SunZillaBerlin/Score/README.md

# SunZilla Score
...is a hard- and software package
