SunZillaBerlin/Score/1 - DOCUMENTATION/5 - Score_PCB_Function_Groups.pdf

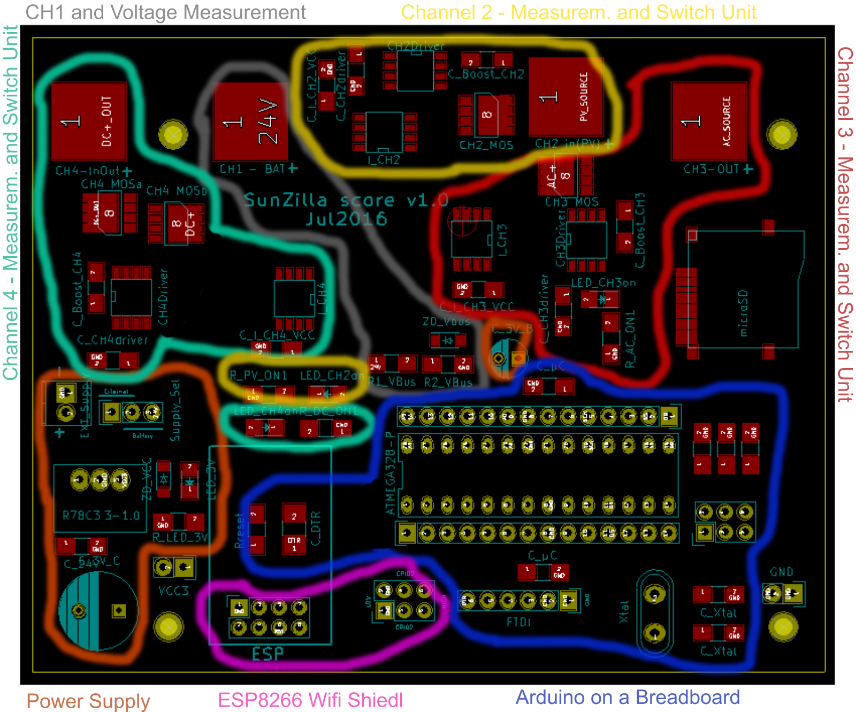
[picture p1: page 1]

PowerSupply | ESP8266WifiShiedl | ArduinoonaBreadboard

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
CH1andVoltageMeasurement Channel2-Measurem.andSwitchUnit
