SunZillaBerlin/Score/1 - DOCUMENTATION/3 - Score_PCB_Overview.pdf

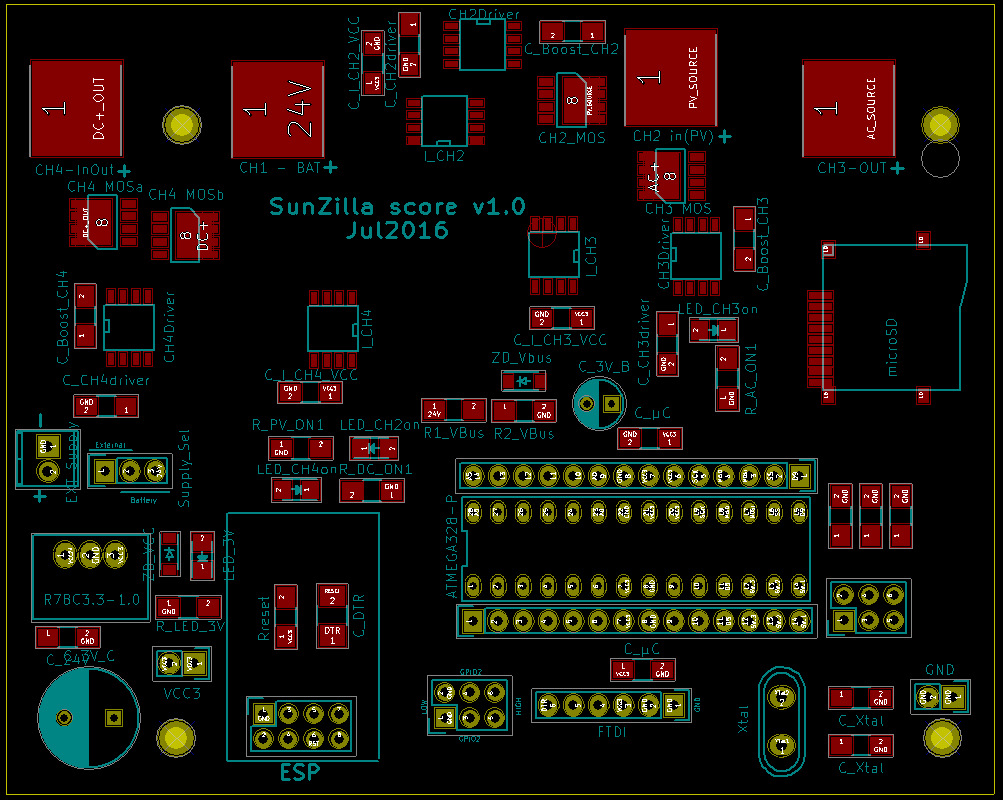
[picture p2: page 1]
