SunZillaBerlin/Score/2 - HARDWARE/KiCad PCB Files/SunZilla_score_v1.stl

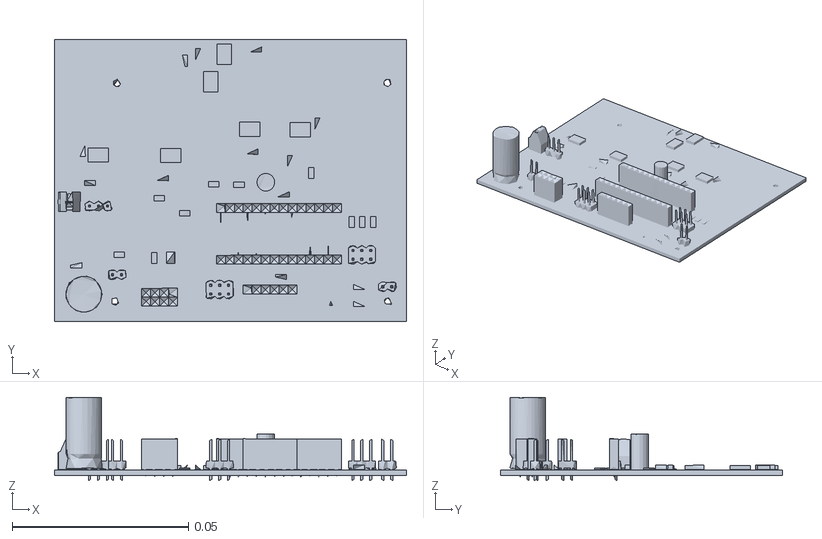
[picture p3: CAD file, 2017-01-20]
2 - HARDWARE/KiCad PCB Files/SunZilla_score_v1.stl
0.1 x 0.08 x 0.0237
