SunZillaBerlin/Score/(list of files, cad)

Other CAD files:
2 - HARDWARE/KiCad PCB Files/SunZilla_score_v1.ply
