SunZillaBerlin/Score/1 - DOCUMENTATION/6 - SunZilla_score_v1.0_testroutine.pdf

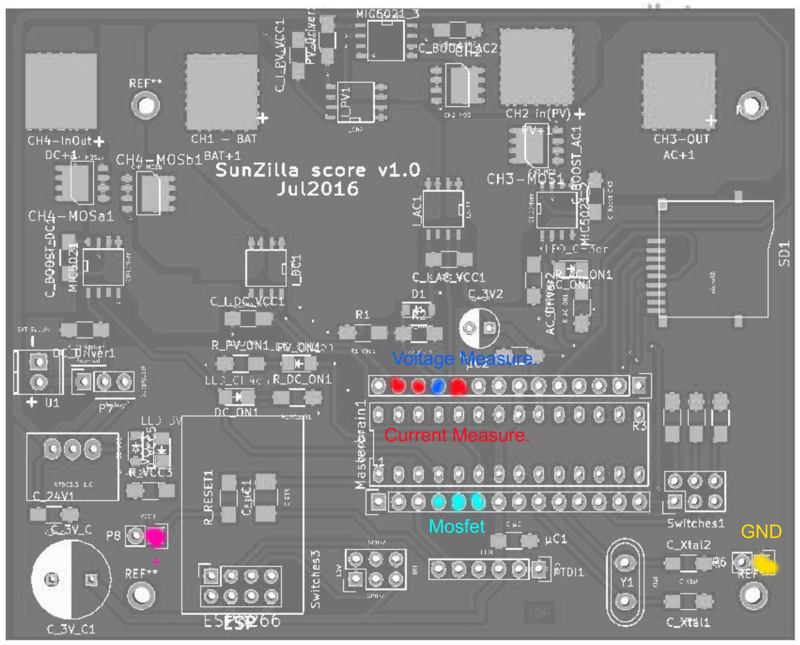
[picture p15: page 1]

Mosfet

CurrentMeasure.

VoltageMeasure.

GND
+
