SunZillaBerlin/Score/2 - HARDWARE/KiCad PCB Files/SunZilla_score_v1.0.kicad_pcb

## KiCad design 2 - HARDWARE/KiCad PCB Files/SunZilla_score_v1.0.kicad_pcb (2017-01-20)

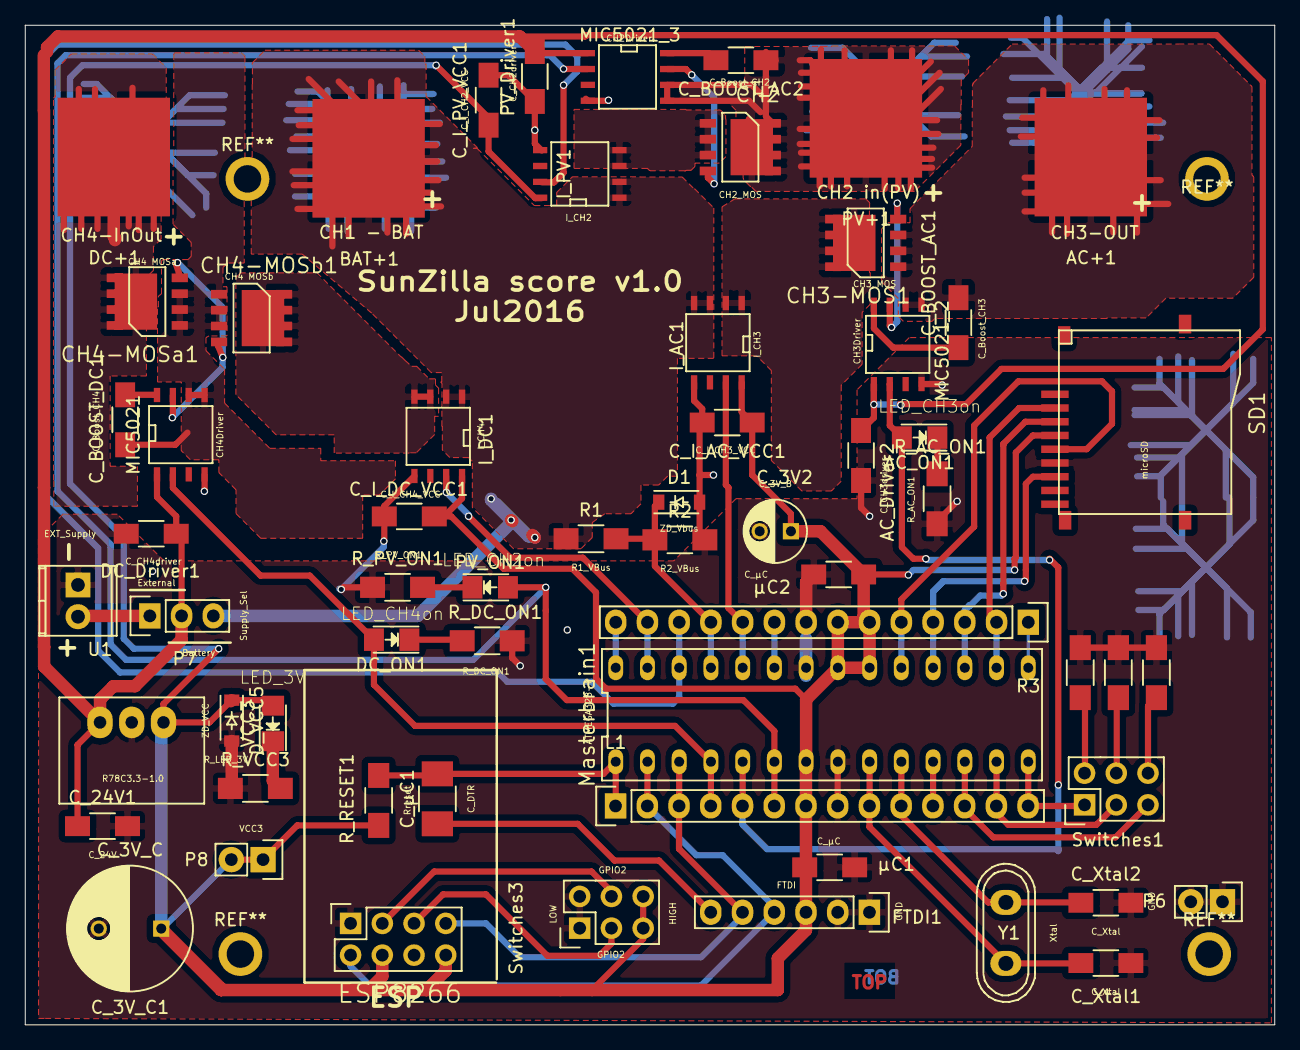
[picture p16: board SunZilla_score_v1.0.kicad_pcb from above]

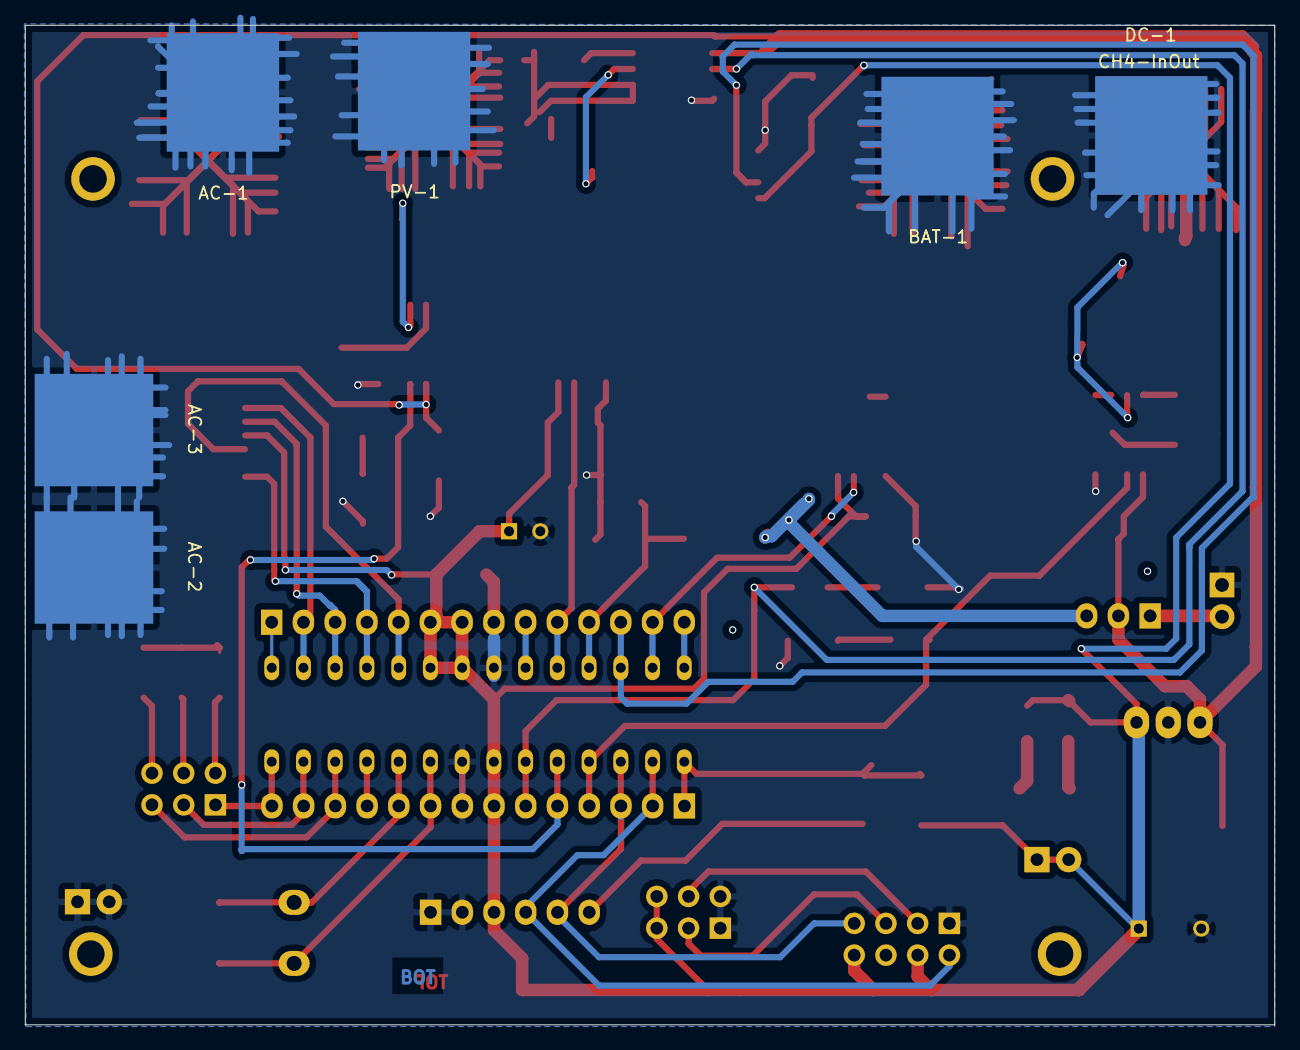
[picture p17: board SunZilla_score_v1.0.kicad_pcb from below]

Board: 2 copper layers, 100.0 x 80.0 mm, 67 parts (6 on the bottom side), 51 nets.

Parts:
AC+1: CH3-OUT; Flachsteckzunge_plus
AC-1, AC-2, AC-3: CH3-OUT; Flachsteckzunge_minus
AC_Driver2: C_CH3driver; C_1206_HandSoldering
AC_ON1: LED_CH3on; LED_1206
BAT+1: CH1 - BAT; Flachsteckzunge_plus
BAT-1: CH1 - BAT; Flachsteckzunge_minus
CH2: CH2_MOS; MOSFET_2
CH3-MOS1: CH3 MOS; MOSFET_2
CH4-MOSa1: CH4 MOSa; MOSFET_2
CH4-MOSb1: CH4 MOSb; MOSFET_2
C_3V2: C_3V_B; C_Radial_D5_L11_P2.5
C_3V_C1: C_3V_C; C_Radial_D10_L20_P5
C_24V1: C_24V; C_1206_HandSoldering
C_BOOST_AC1: C_Boost_CH3; C_1206_HandSoldering
C_BOOST_AC2: C_Boost_CH2; C_1206_HandSoldering
C_BOOST_DC1: C_Boost_CH4; C_1206_HandSoldering
C_I_AC_VCC1: C_I_CH3_VCC; C_1206_HandSoldering
C_I_DC_VCC1: C_I_CH4_VCC; C_1206_HandSoldering
C_I_PV_VCC1: C_I_CH2_VCC; C_1206_HandSoldering
C_Xtal1, C_Xtal2: C_Xtal; C_1206_HandSoldering
C_µC1: C_DTR; C_1210_HandSoldering
D1: ZD_Vbus; SOD-123
DC+1: CH4-InOut; Flachsteckzunge_plus
DC-1: CH4-InOut; Flachsteckzunge_minus
DC_Driver1: C_CH4driver; C_1206_HandSoldering
DC_ON1: LED_CH4on; LED_1206
D_VCC5: ZD_VCC; SOD-123
ESP8266: CONN_02X04; Socket_Strip_Straight_2x04
FTDI1: FTDI; Socket_Strip_Straight_1x06
I_AC1: I_CH3; SOIC-8-N
I_DC1: I_CH4; SOIC-8-N
I_PV1: I_CH2; SOIC-8-N
L1: CONN_01X14; Socket_Strip_Straight_1x14
MIC5021: CH4Driver; SOIC-8-N
MIC5021_2: CH3Driver; SOIC-8-N
MIC5021_3: CH2Driver; SOIC-8-N
Masterbrain1: ATMEGA328-P; DIP-28
P5: EXT_Supply; TerminalBlock_Pheonix_MPT-2.54mm_2pol
P6: GND; Pin_Header_Straight_1x02
P7: Supply_Sel; Pin_Header_Straight_1x03
P8: VCC3; Pin_Header_Straight_1x02
PV+1: CH2 in(PV); Flachsteckzunge_plus
PV-1: CH2 in(PV); Flachsteckzunge_minus
PV_Driver1: C_CH2driver; C_1206_HandSoldering
PV_ON1: LED_CH2on; LED_1206
R1: R1_VBus; R_1206_HandSoldering
R2: R2_VBus; R_1206_HandSoldering
R3: CONN_01X14; Socket_Strip_Straight_1x14
R_AC_ON1: R_AC_ON1; R_1206_HandSoldering
R_DC_ON1: R_DC_ON1; R_1206_HandSoldering
R_PV_ON1: R_PV_ON1; R_1206_HandSoldering
R_RESET1: Rreset; R_1206_HandSoldering
R_SW1: R_switch; R_1206_HandSoldering
R_SW2, R_SW3: 16k; R_1206_HandSoldering
R_VCC3: R_LED_3V; R_1206_HandSoldering
SD1: microSD
Switches1, Switches3: Switches; Pin_Header_Straight_2x03
U1: R78C3.3-1.0; DCDC-Conv_Recom_R-78HBxx-0.5
VCC3: LED_3V; LED_1206
Y1: Xtal; Crystal_HC50-U_Vertical
µC1, µC2: C_µC; C_1206_HandSoldering

Connections:
/24V: BAT+1.1, I_AC1.3, I_AC1.4, I_DC1.1, I_DC1.2, I_PV1.1, I_PV1.2, P7.3, R1.1
/A0: Masterbrain1.23, R3.9
/A5: Masterbrain1.28, R3.14
/AC+: CH3-MOS1.5, CH3-MOS1.6, CH3-MOS1.7, CH3-MOS1.8, I_AC1.1, I_AC1.2
/AC_GATE: CH3-MOS1.4, MIC5021_2.7
/AC_GO: AC_ON1.2, L1.5, MIC5021_2.2, Masterbrain1.5
/AC_SOURCE: AC+1.1, CH3-MOS1.1, CH3-MOS1.2, CH3-MOS1.3, C_BOOST_AC1.1, MIC5021_2.5, MIC5021_2.6
/D5: L1.11, Masterbrain1.11
/D9: Masterbrain1.15, R3.1
/DC+: CH4-MOSb1.5, CH4-MOSb1.6, CH4-MOSb1.7, CH4-MOSb1.8, I_DC1.3, I_DC1.4
/DC+_OUT: CH4-MOSa1.5, CH4-MOSa1.6, CH4-MOSa1.7, CH4-MOSa1.8, DC+1.1
/DC_GATE: CH4-MOSa1.4, CH4-MOSb1.4, MIC5021.7
/DC_GO: DC_ON1.2, L1.4, MIC5021.2, Masterbrain1.4
/DC_SOURCE: CH4-MOSa1.1, CH4-MOSa1.2, CH4-MOSa1.3, CH4-MOSb1.1, CH4-MOSb1.2, CH4-MOSb1.3, C_BOOST_DC1.1, MIC5021.5, MIC5021.6
/DTR: C_µC1.1, FTDI1.6
/Ext_24V: P5.2, P7.1
/GND: AC-1.1, AC-2.1, AC-3.1, AC_Driver2.2, BAT-1.1, C_3V2.2, C_3V_C1.2, C_24V1.2, C_I_AC_VCC1.2, C_I_DC_VCC1.2, C_I_PV_VCC1.2, C_Xtal1.2, C_Xtal2.2, D1.2, DC-1.1, DC_Driver1.2, D_VCC5.2, ESP8266.1, FTDI1.1, FTDI1.2, I_AC1.5, I_DC1.5, I_PV1.5, L1.8, MIC5021.4, MIC5021_2.4, MIC5021_3.4, Masterbrain1.8, Masterbrain1.22, P5.1, P6.1, P6.2, PV-1.1, PV_Driver1.2, R2.2, R3.8, R_AC_ON1.1, R_DC_ON1.1, R_PV_ON1.1, R_SW1.2, R_SW2.2, R_SW3.2, R_VCC3.1, SD1.6, Switches3.1, Switches3.2, U1.2, µC1.2, µC2.2
/GPIO0: ESP8266.5, Switches3.3
/GPIO2: ESP8266.3, Switches3.4
/I_AC_3: I_AC1.7, Masterbrain1.24, R3.10
/I_DC_3: I_DC1.7, Masterbrain1.27, R3.13
/I_PV_3: I_PV1.7, Masterbrain1.26, R3.12
/MISO: Masterbrain1.18, R3.4, SD1.7
/MOSI: Masterbrain1.17, R3.3, SD1.3
/PV+: CH2.1, CH2.2, CH2.3, I_PV1.3, I_PV1.4
/PV_GATE: CH2.4, MIC5021_3.7
/PV_GO: L1.6, MIC5021_3.2, Masterbrain1.6, PV_ON1.2
/PV_SOURCE: CH2.5, CH2.6, CH2.7, CH2.8, C_BOOST_AC2.1, MIC5021_3.5, MIC5021_3.6, PV+1.1
/RESET: C_µC1.2, L1.1, Masterbrain1.1, R_RESET1.2
/RX_ATm: ESP8266.2, FTDI1.4, L1.2, Masterbrain1.2
/RX_ESP: ESP8266.7, FTDI1.5, L1.3, Masterbrain1.3
/SCK: Masterbrain1.19, R3.5, SD1.5
/SS: Masterbrain1.16, R3.2, SD1.2
/SW_1: L1.14, Masterbrain1.14, Switches1.1
/SW_2: L1.13, Masterbrain1.13, Switches1.3
/SW_3: L1.12, Masterbrain1.12, Switches1.5
/VCC3: C_3V2.1, C_3V_C1.1, C_I_AC_VCC1.1, C_I_DC_VCC1.1, C_I_PV_VCC1.1, D_VCC5.1, ESP8266.4, ESP8266.8, FTDI1.3, I_AC1.8, I_DC1.8, I_PV1.8, L1.7, Masterbrain1.7, Masterbrain1.20, Masterbrain1.21, P8.1, P8.2, R3.6, R3.7, R_RESET1.1, SD1.4, Switches3.5, Switches3.6, U1.3, VCC3.2, µC1.1, µC2.1
/VCC24: AC_Driver2.1, C_24V1.1, DC_Driver1.1, MIC5021.1, MIC5021_2.1, MIC5021_3.1, P7.2, PV_Driver1.1, U1.1
/V_BUS: D1.1, Masterbrain1.25, R1.2, R2.1, R3.11
/XTal1: C_Xtal1.1, L1.9, Masterbrain1.9, Y1.1
/XTal2: C_Xtal2.1, L1.10, Masterbrain1.10, Y1.2
unnamed: AC_ON1.1, R_AC_ON1.2
unnamed: C_BOOST_AC1.2, MIC5021_2.8
unnamed: C_BOOST_AC2.2, MIC5021_3.8
unnamed: C_BOOST_DC1.2, MIC5021.8
unnamed: DC_ON1.1, R_DC_ON1.2
unnamed: PV_ON1.1, R_PV_ON1.2
unnamed: R_SW1.1, Switches1.2
unnamed: R_SW2.1, Switches1.4
unnamed: R_SW3.1, Switches1.6
unnamed: R_VCC3.2, VCC3.1
